VISmodding/Watara-Supervision-ONLY-IPS-LCD-MOD/Board_preparation_hinged.md

[Back to homepage](README.md)

# Board preparation: Hinged version
Components to desolder (**required step**):

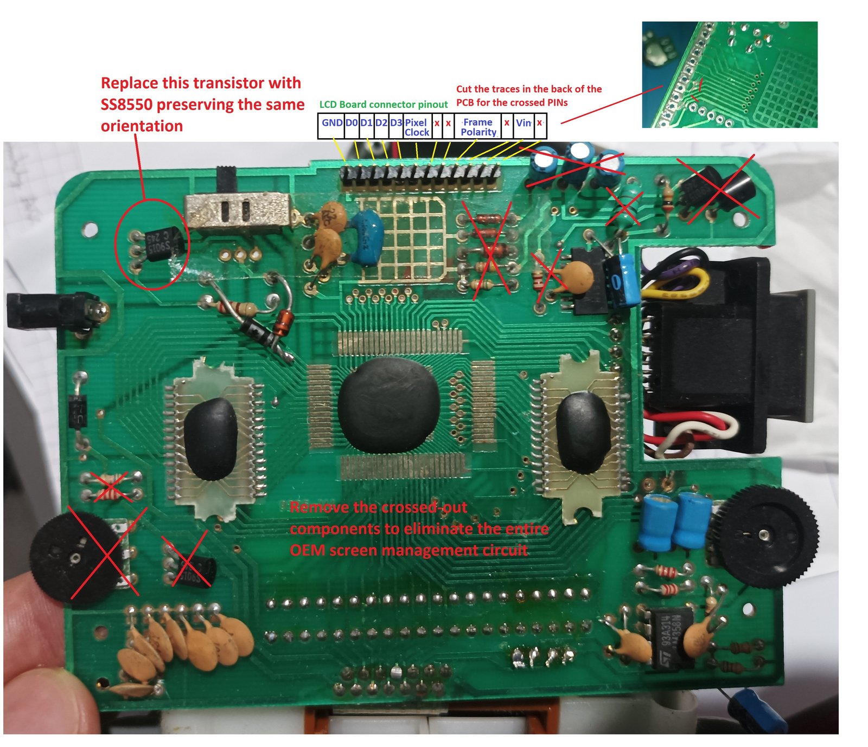
[picture p6: images/Board_preparation1.jpg]

 
Result:

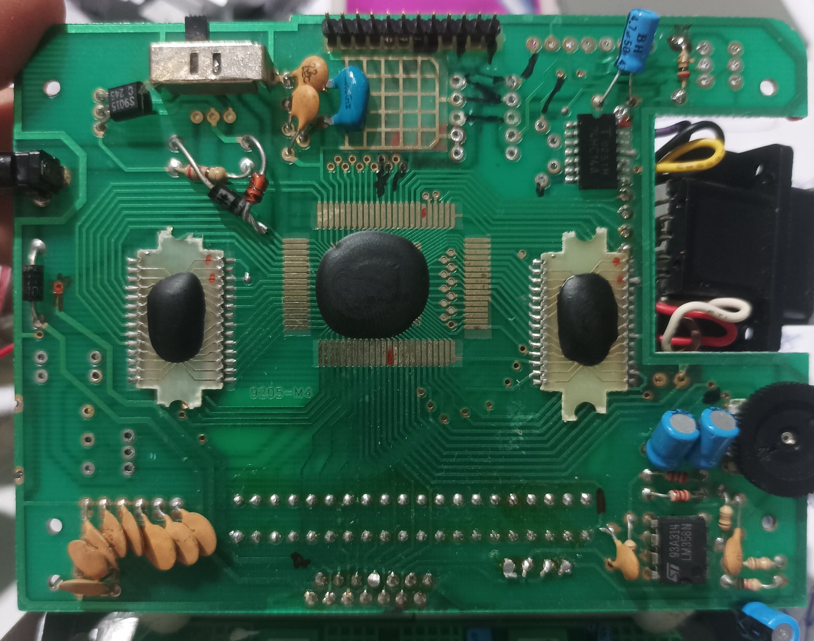
[picture p7: images/Board_preparation2.jpg]

 
Components to be refreshed (**optional step**).

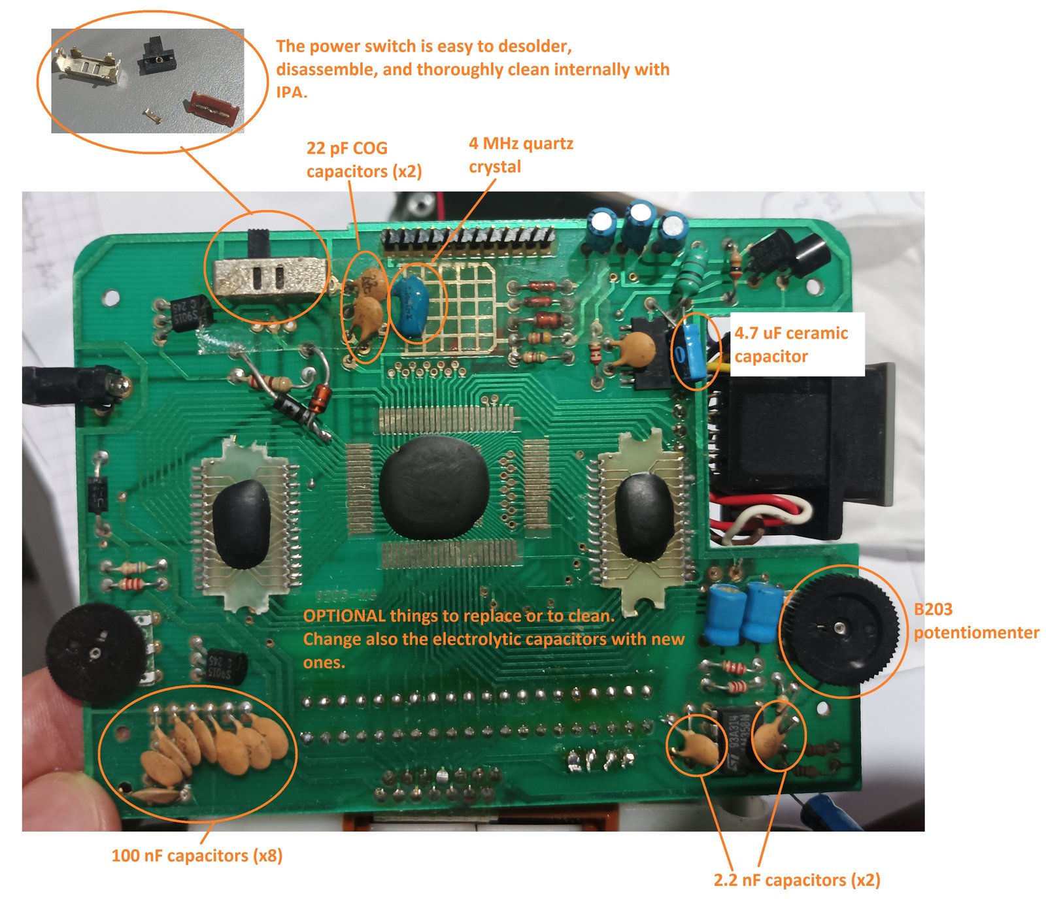
[picture p8: images/Board_preparation3.jpg]

 
Result:

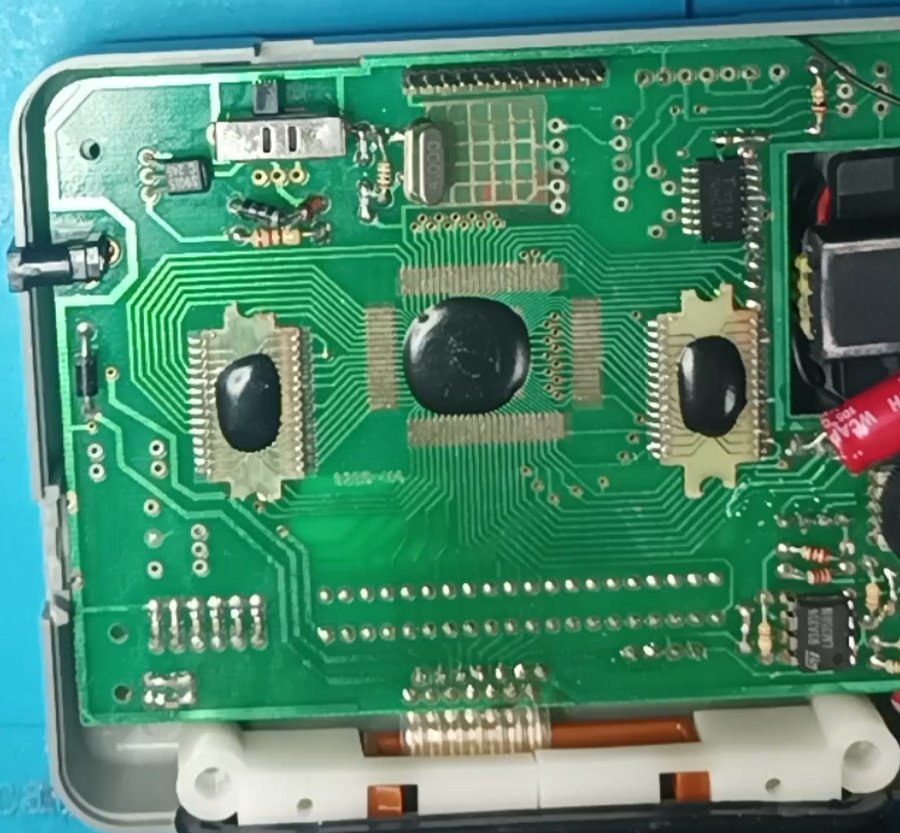
[picture p9: images/Board_preparation4.jpg]

 
Final step: solder the IPS wheel PCB (and the 4 wires as shown).

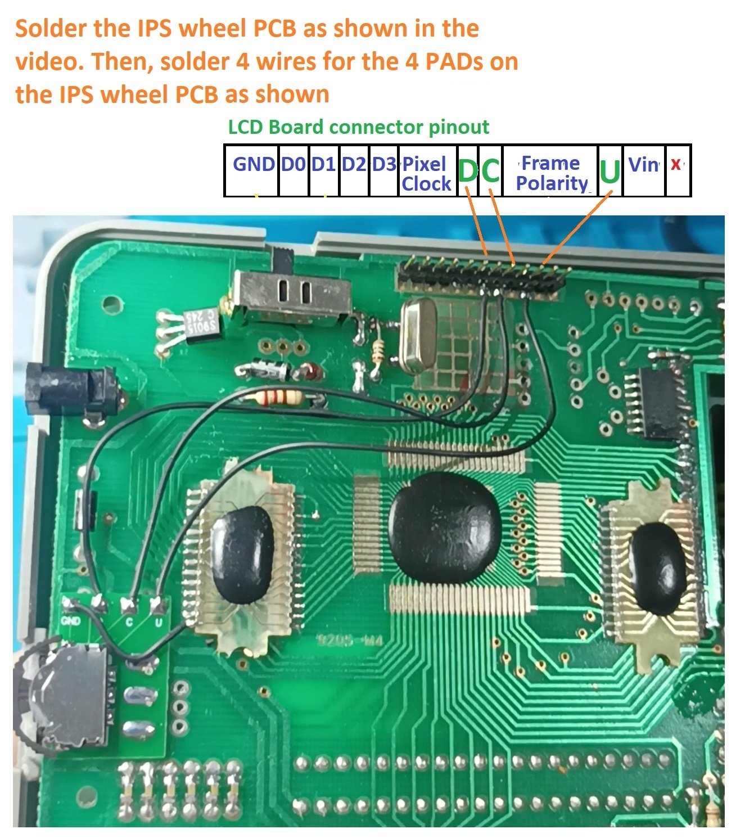
[picture p10: images/Hinged_motherboard_prepared.jpg]


[Back to homepage](README.md)
