VISmodding/Watara-Supervision-ONLY-IPS-LCD-MOD/Board_preparation_unhinged.md

[Back to homepage](README.md)

# Board preparation: Unhinged version
Components to desolder (**required step**):

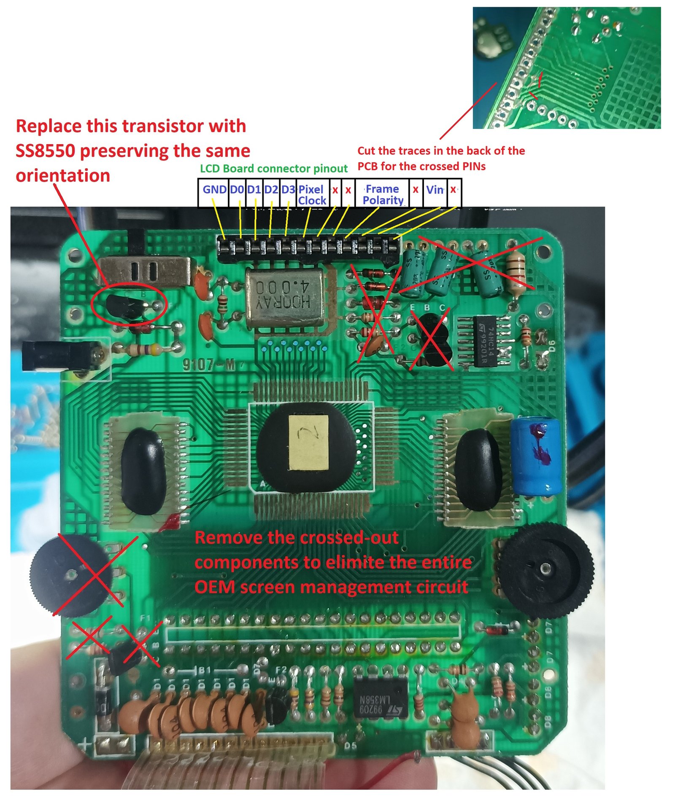
[picture p11: images/Board_preparation5.jpg]

 
Components to be refreshed (**optional step**). As you can see in the following image, I have also desoldered the LCD connector (it is needed for the last step).

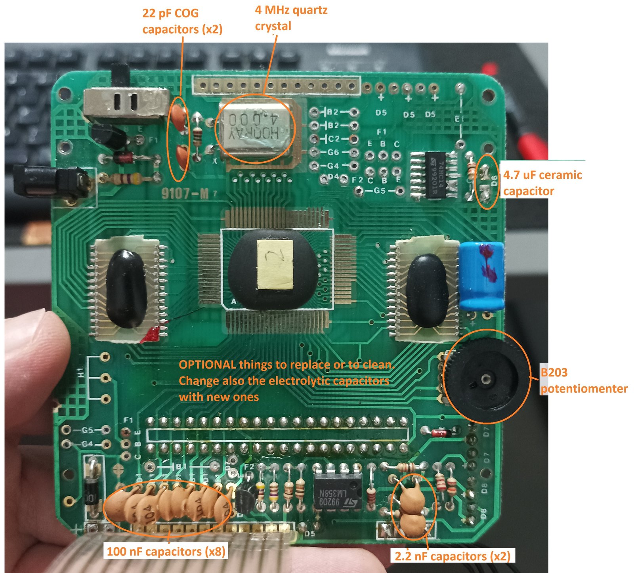
[picture p12: images/Board_preparation6.jpg]


Final step: solder the IPS wheel PCB (and the 4 wires as shown). The result is not as clean as on the hinged version, but this way the same IPS wheel PCB and IPS PCB can be reused.

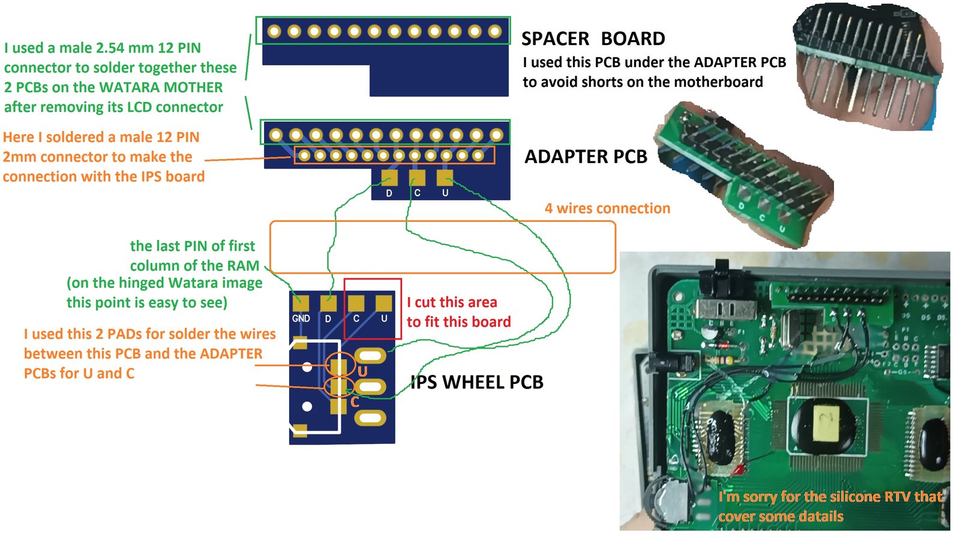
[picture p13: images/Unhinged_motherboard_prepared.jpg]


[Back to homepage](README.md)
