VISmodding/Watara-Supervision-ONLY-IPS-LCD-MOD/Bracket_and_gerbers_files/SV_LCD_BBRACKET_VIS.stl

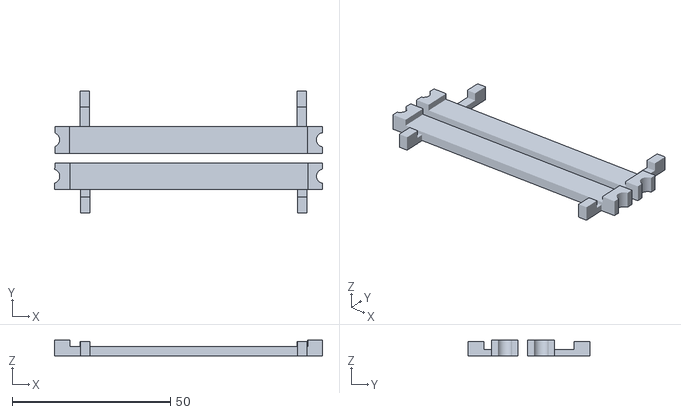
[picture p17: CAD file, 2026-10-21]
Bracket_and_gerbers_files/SV_LCD_BBRACKET_VIS.stl
84.6 x 38.5 x 5.00
